bcouraud/Linky-TIC-Redaer/Publication/ISGT_2023/LaTEX/Images/dongle_Linky.jpg

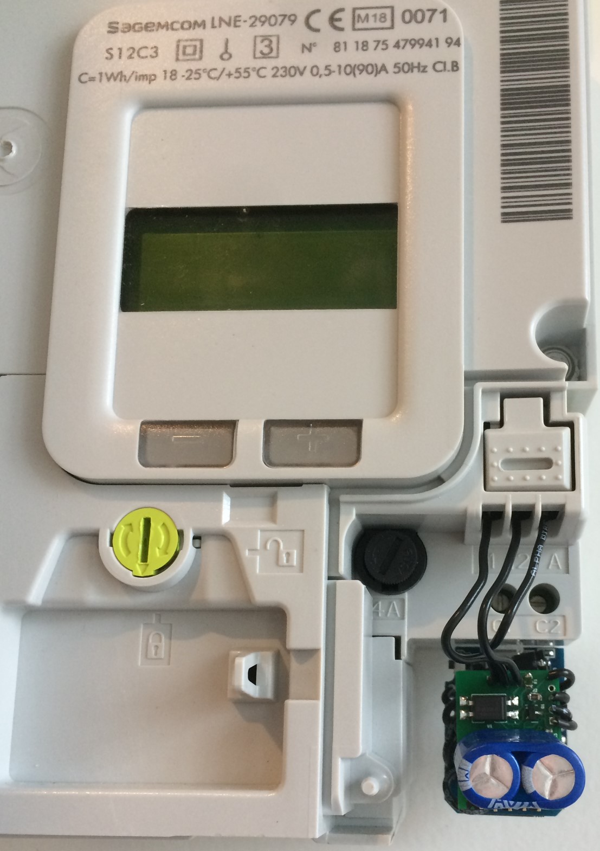
Publication/ISGT_2023/LaTEX/Images/dongle_Linky.jpg
