bcouraud/Linky-TIC-Redaer/Publication/ISGT_2023/LaTEX/Images/dongle_Linky2.jpg

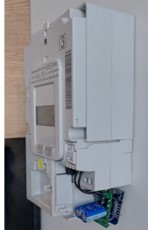
Publication/ISGT_2023/LaTEX/Images/dongle_Linky2.jpg
