bcouraud/Linky-TIC-Redaer/Publication/ISGT_2023/LaTEX/fig1.png

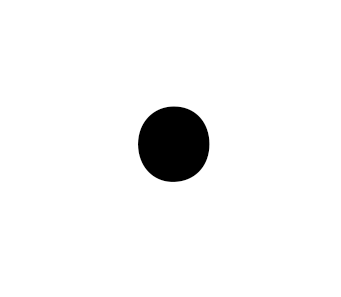
Publication/ISGT_2023/LaTEX/fig1.png
