bcouraud/Linky-TIC-Redaer/Publication/ISGT_2023/LaTEX/Images/load_curvesEV.png

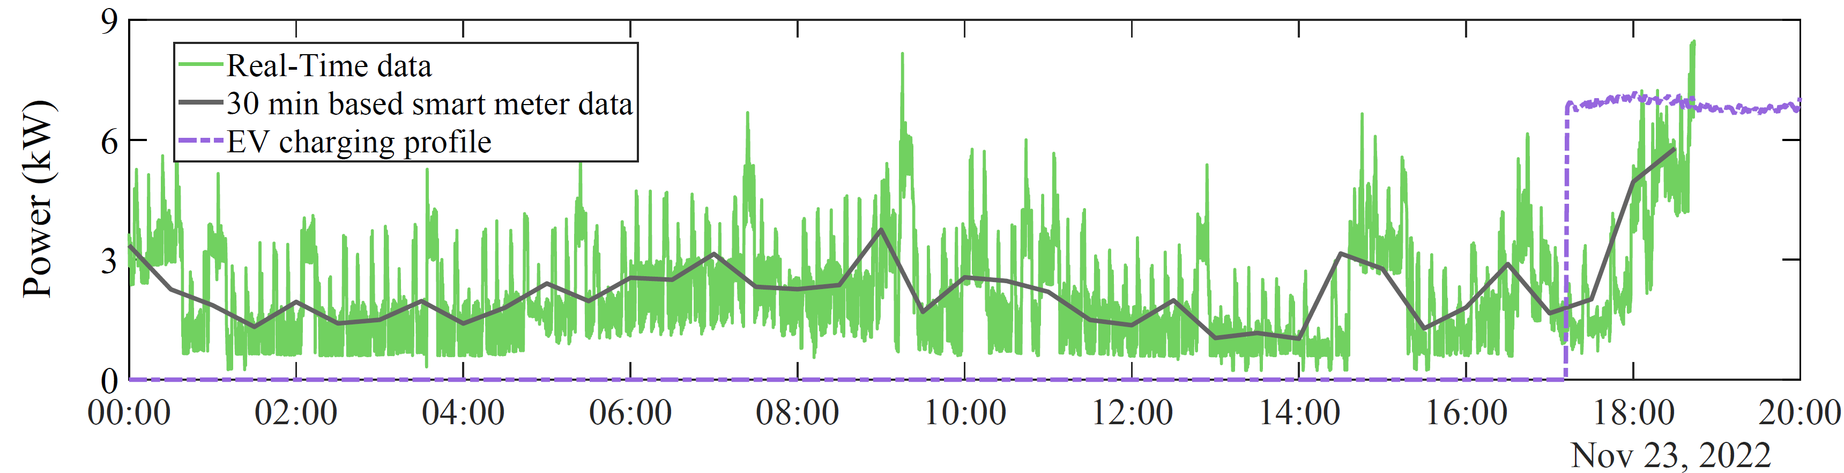
Publication/ISGT_2023/LaTEX/Images/load_curvesEV.png
