bcouraud/Linky-TIC-Redaer/Publication/ISGT_2023/LaTEX/Images/olddongle_Linky.jpeg

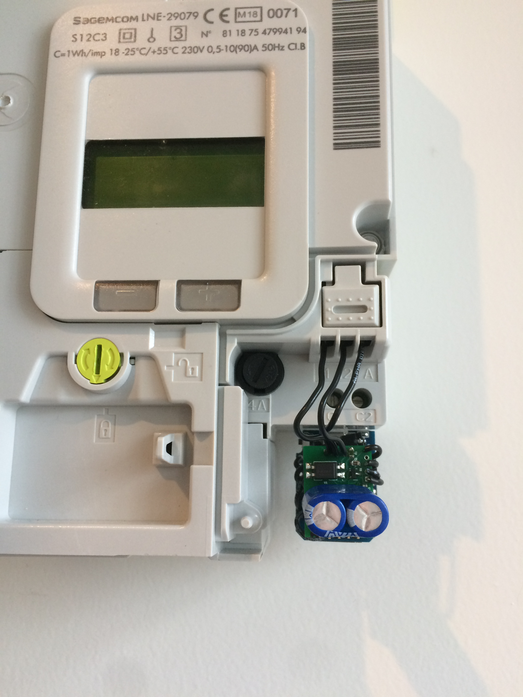
Publication/ISGT_2023/LaTEX/Images/olddongle_Linky.jpeg
