bcouraud/Linky-TIC-Redaer/Publication/ISGT_2023/Matlab/Freq_Data_Dongle_and_NILM_results.xlsx

Sheet: Sheet1
Time,"power LinkyLivingLab" |  | Time,"power LinkyLivingLab"
168429442630 | 9.99 | 168429442630
168429452620 | 6 | 168429452620 | 168429442630
168429458620 | 4.01 | 168429458620 | 168429452620 |  |  |  |  |  | timeDiff
168429462630 | 3.99 | 168429462630 | 168429458620 | 2023-05-20 | 6:03:49 PM | 695 | 192 | 1684598629 | 38 | 0 | 2 | 1
168429466620 | 6 | 168429466620 |  | 2023-05-20 | 6:04:27 PM | 670 | 192 | 1684598667 | 36 | 0 | 2 | 1
168429472620 | 12 | 168429472620 |  | 2023-05-20 | 6:05:03 PM | 675 | 192 | 1684598703 | 36 | 0 | 2 | 1
168429484620 | 4.01 | 168429484620 |  | 2023-05-20 | 6:05:39 PM | 675 | 192 | 1684598739 | 34 | 0 | 2 | 1
168429488630 | 6 | 168429488630 |  | 2023-05-20 | 6:06:13 PM | 670 | 192 | 1684598773 | 35 | 0 | 2 | 1
168429494630 | 3.99 | 168429494630 |  | 2023-05-20 | 6:06:48 PM | 670 | 192 | 1684598808 | 37 | 0 | 2 | 1
168429498620 | 4 | 168429498620 |  | 2023-05-20 | 6:07:25 PM | 675 | 192 | 1684598845 | 36 | 0 | 2 | 1
168429502620 | 6 | 168429502620 |  | 2023-05-20 | 6:08:01 PM | 675 | 194 | 1684598881 | 25 | 0 | 2 | 1
168429508620 | 12 | 168429508620 |  | 2023-05-20 | 6:08:26 PM | 670 | 192 | 1684598906 | 68 | 0 | 1 | 1
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
