bcouraud/Linky-TIC-Redaer/PCB/2023_11_PCB_Dongle_Linky_Full_CMS_WEMO/PCB_Dongle_Linky.kicad_pcb

## KiCad design PCB/2023_11_PCB_Dongle_Linky_Full_CMS_WEMO/PCB_Dongle_Linky.kicad_pcb (2023-12-29)

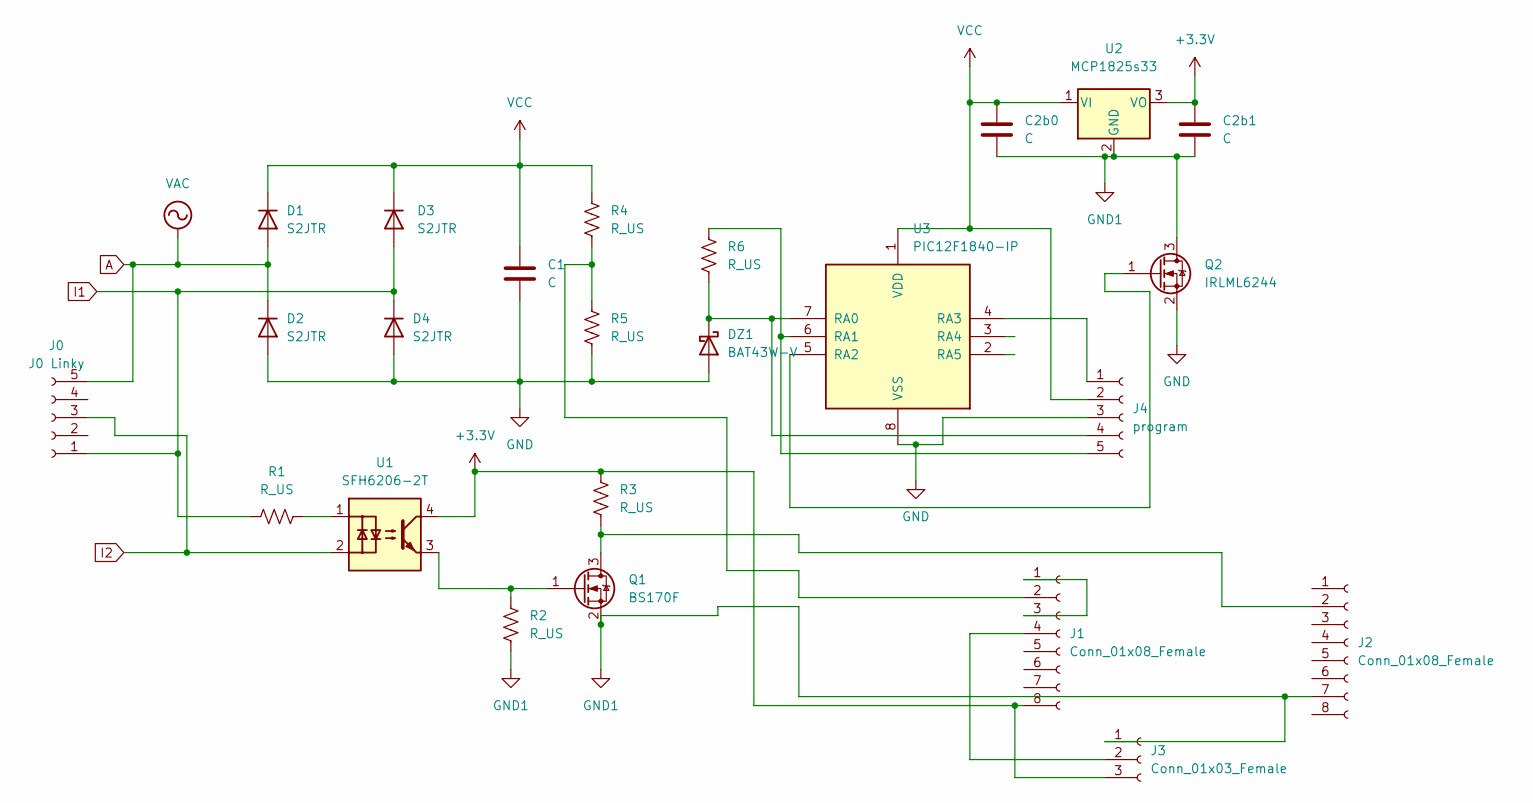
[picture p60: schematic PCB_Dongle_Linky.kicad_sch]

Parts:
C1: C; C_Rect_L19.0mm_W11.0mm_P15.00mm_MKS4
C2b0, C2b1: C; C_0805_2012Metric
D1, D2, D3, D4: S2JTR; D_SMB
DZ1: BAT43W-V; D_SOD-123
J0: J0 Linky; PinHeader_1x05_P2.54mm_Vertical
J1, J2: Conn_01x08_Female; PinHeader_1x08_P2.54mm_Vertical
J3: Conn_01x03_Female; PinHeader_1x03_P2.54mm_Vertical
J4: program; PinHeader_1x05_P2.54mm_Vertical
Q1: BS170F; SOT-23
Q2: IRLML6244; SOT-23
R1, R2, R3, R4, R5, R6: R_US; R_0805_2012Metric
U1: SFH6206-2T; SMDIP-4_W9.53mm_Clearance8mm
U2: MCP1825s33; SOT-223-3_TabPin2
U3: PIC12F1840-IP; SOIC-8_3.9x4.9mm_P1.27mm

Connections:
+3.3V: C2b1.1, J1.8, J3.3, R3.2, U1.4, U2.3 (VO)
A: D1.2 (A), D2.1 (K), J0.5
GND: C1.2, D2.2 (A), D4.2 (A), DZ1.2 (A), J4.3, Q2.2 (S), R5.1, U3.8 (VSS)
GND1: C2b0.2, C2b1.2, J2.7, J3.1, Q1.2 (S), Q2.3 (D), R2.1, U2.2 (GND)
I1: D3.2 (A), D4.1 (K), J0.1, R1.1
I2: J0.3, U1.2
unnamed: DZ1.1 (K), J4.4, R6.1, U3.7 (RA0)
unnamed: J1.1, J1.3
unnamed: J1.2, R4.1, R5.2
unnamed: J1.4, J3.2
unnamed: J2.2, Q1.3 (D), R3.1
unnamed: J4.1, U3.4 (RA3)
unnamed: J4.5, R6.2, U3.6 (RA1)
unnamed: Q1.1 (G), R2.2, U1.3
unnamed: Q2.1 (G), U3.5 (RA2)
unnamed: R1.2, U1.1
VCC: C1.1, C2b0.1, D1.1 (K), D3.1 (K), J4.2, R4.2, U2.1 (VI), U3.1 (VDD)

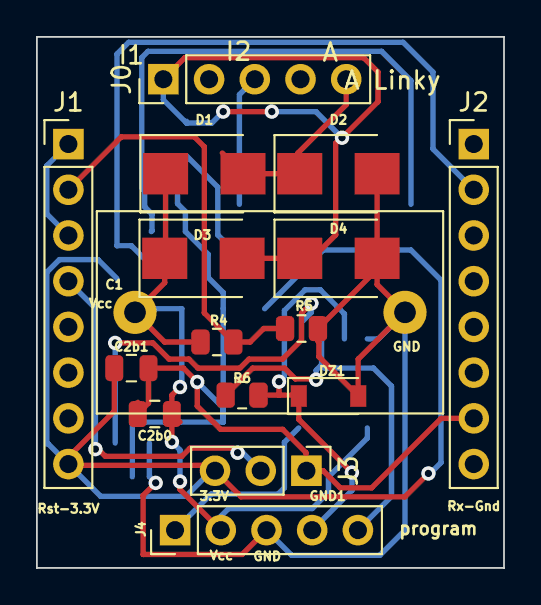
[picture p61: board PCB_Dongle_Linky.kicad_pcb from above]

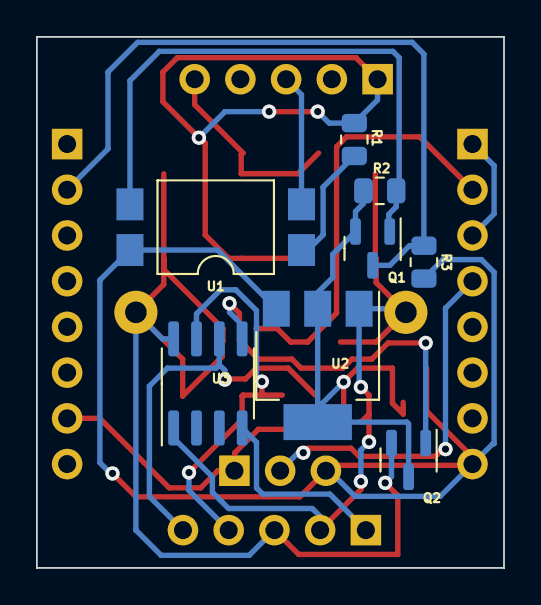
[picture p62: board PCB_Dongle_Linky.kicad_pcb from below]

Board: 2 copper layers, 26.0 x 29.5 mm, 24 parts (8 on the bottom side), 17 nets.
