bcouraud/Linky-TIC-Redaer/(commit log)

2023-12-29 Add PCB and arduino Code revised to the main branch
    [PCB_Dongle_Linky-B_Cu.gbl, PCB_Dongle_Linky-B_Mask.gbs, PCB_Dongle_Linky-B_Paste.gbp, PCB_Dongle_Linky-B_Silkscreen.gbo, PCB_Dongle_Linky-Edge_Cuts.gm1, PCB_Dongle_Linky-F_Cu.gtl, PCB_Dongle_Linky-F_Mask.gts, PCB_Dongle_Linky-F_Paste.gtp]
2024-09-25 full update of this directory
    [AppartmentLoadProfile.xlsx, Book1.xlsx, Forecasting_Study.xlsx, Freq_Data_Dongle_and_NILM_results.xlsx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]
